amsikking/SOLS_O2-O3_optomechanics/animation/images/img0.png

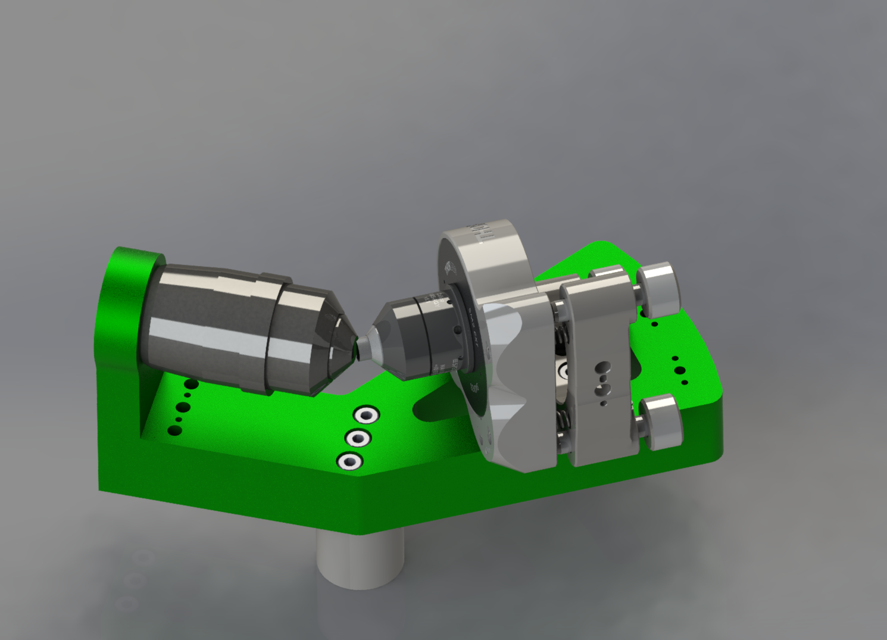
animation/images/img0.png
