amsikking/SOLS_O2-O3_optomechanics/animation/images/img1.png

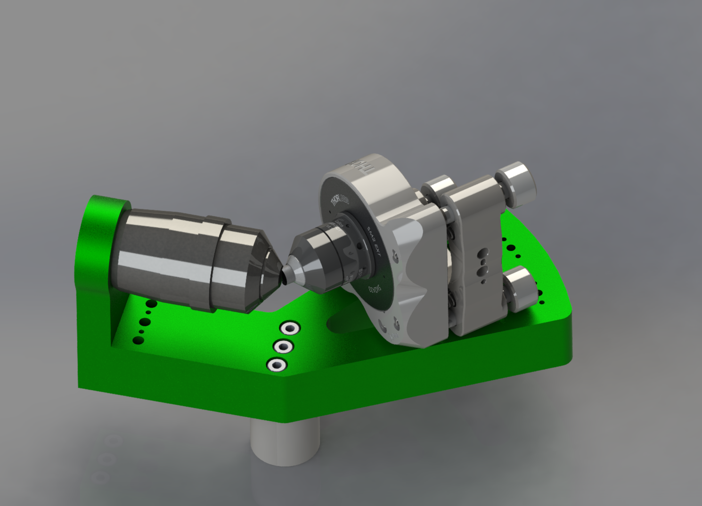
animation/images/img1.png
