amsikking/SOLS_O2-O3_optomechanics/animation/images/img2.png

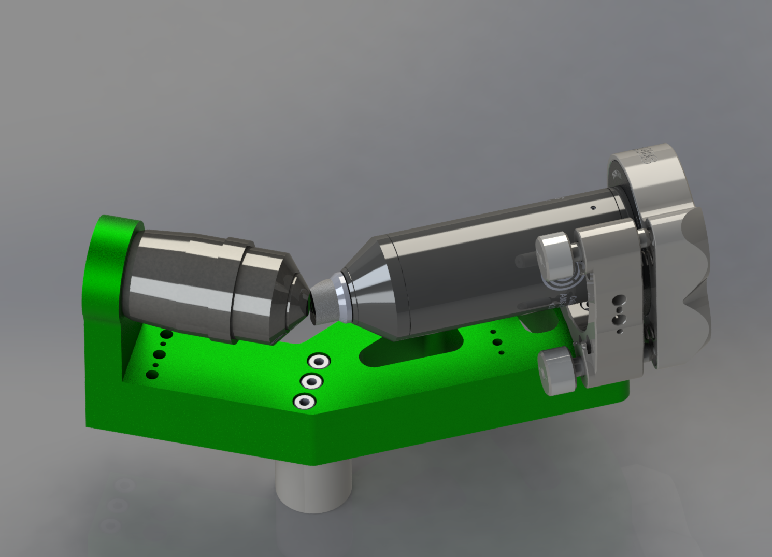
animation/images/img2.png
