amsikking/SOLS_O2-O3_optomechanics/animation/images/img3.png

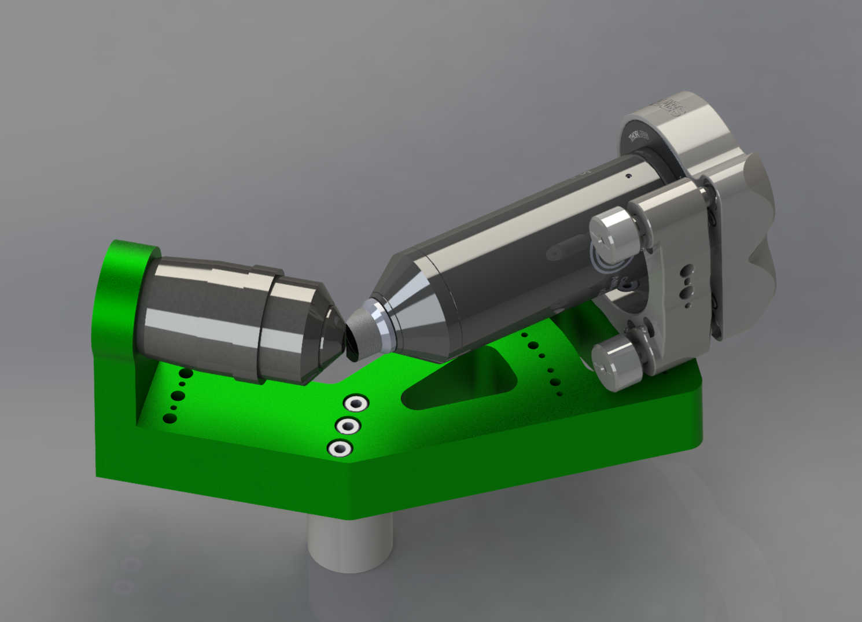
animation/images/img3.png
