amsikking/SOLS_O2-O3_optomechanics/animation/images/img7.png

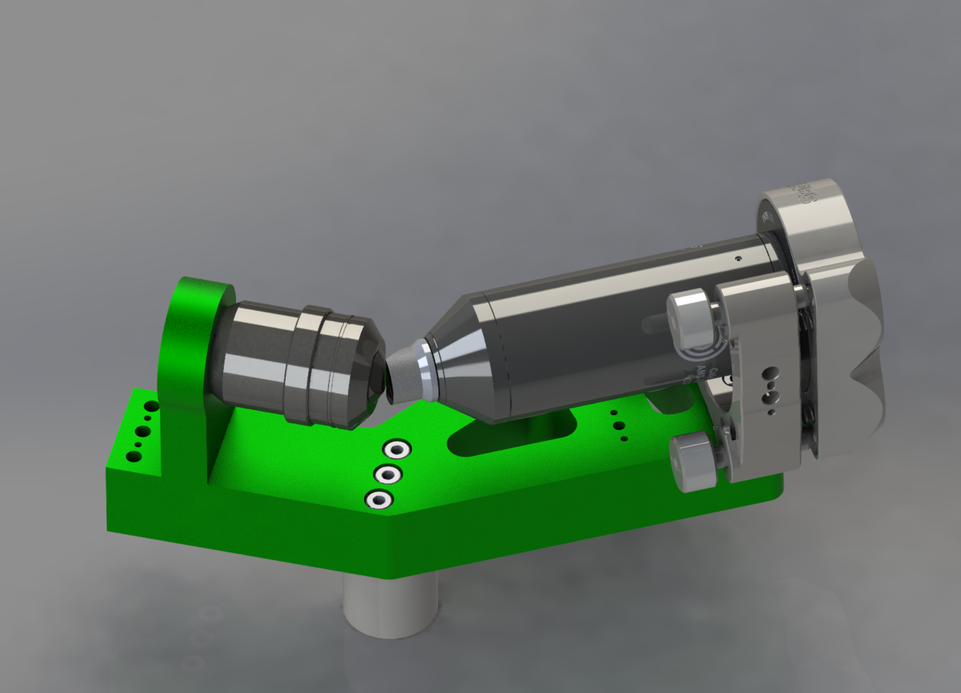
animation/images/img7.png
