amsikking/SOLS_O2-O3_optomechanics/animation/images/img9.png

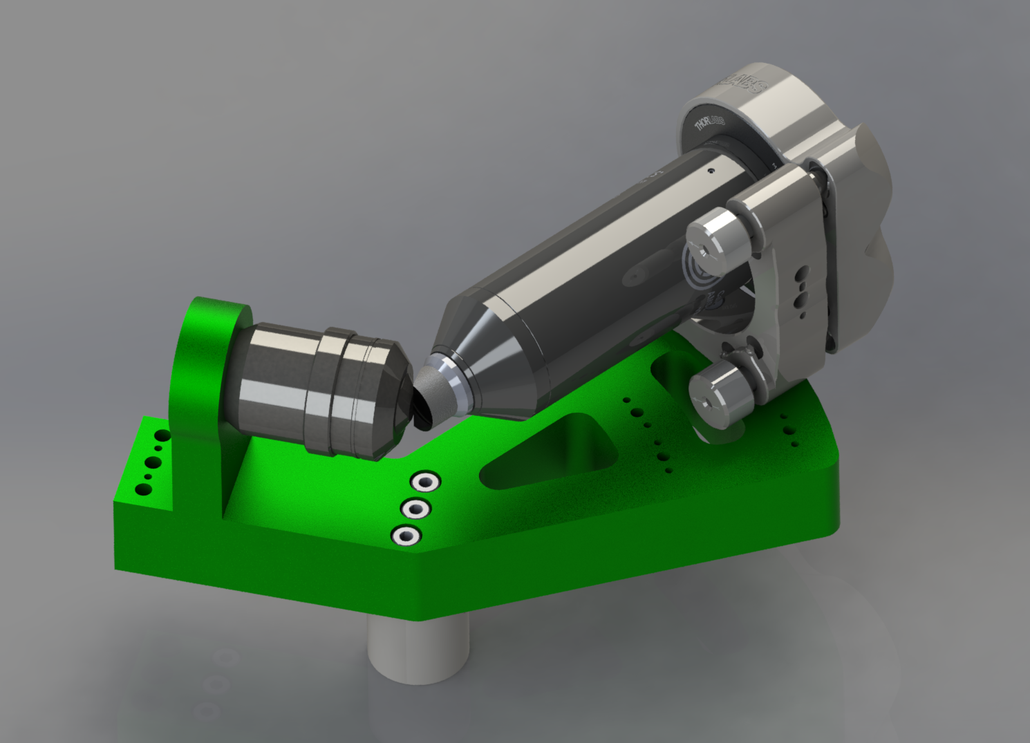
animation/images/img9.png
