amsikking/SOLS_O2-O3_optomechanics/nikon/MRD70470_40x0.95air_objective.png

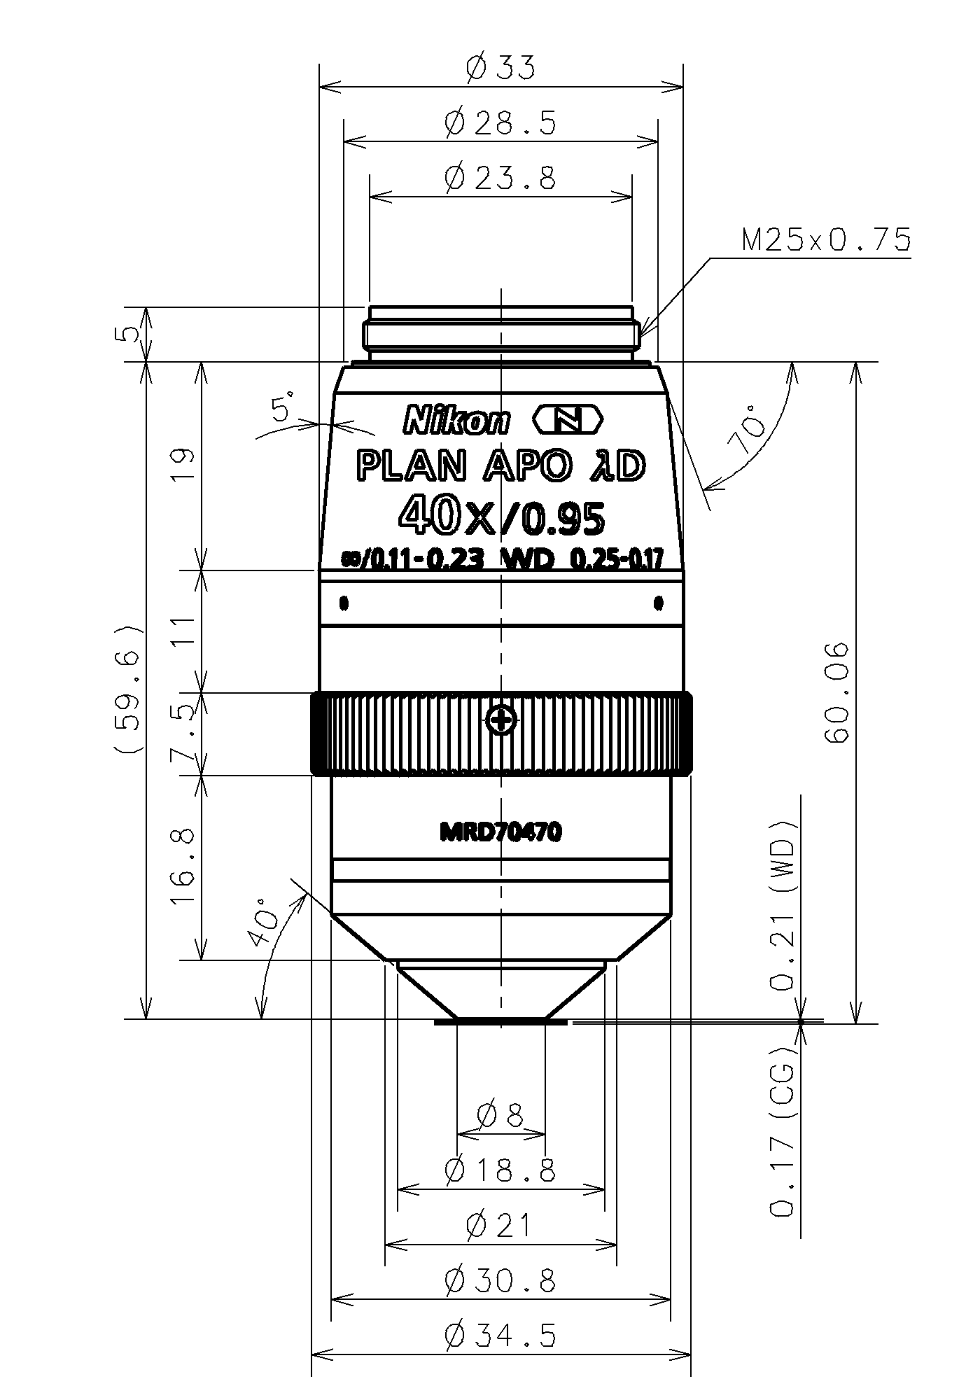
nikon/MRD70470_40x0.95air_objective.png
