amsikking/SOLS_O2-O3_optomechanics/olympus/UPLXAPO40x_40x0.95air_objective.jpg

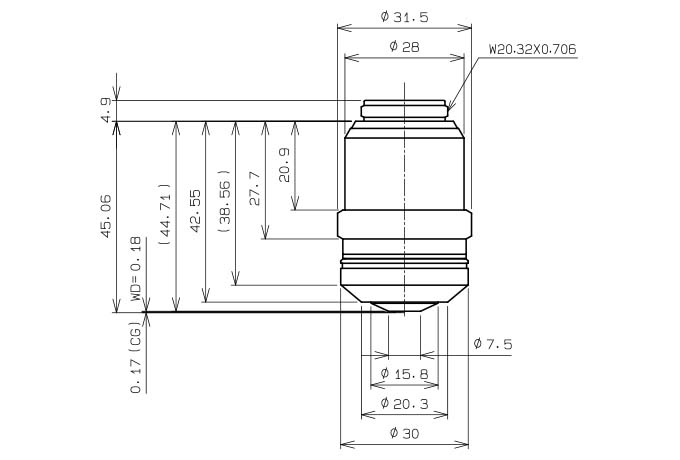
olympus/UPLXAPO40x_40x0.95air_objective.jpg
