amsikking/SOLS_O2-O3_optomechanics/stiffness_testing/02_optical_table.jpg

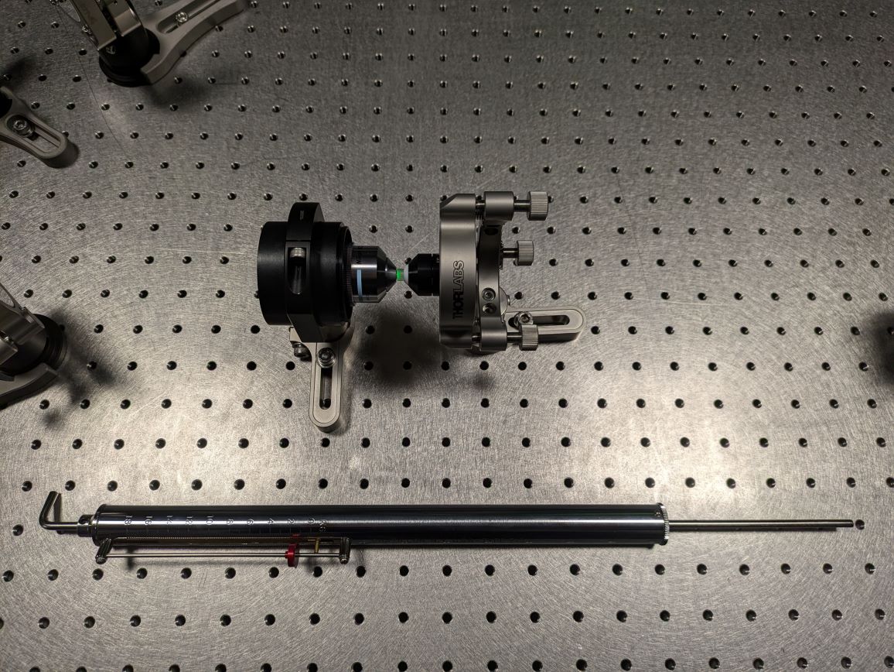
stiffness_testing/02_optical_table.jpg
