amsikking/SOLS_O2-O3_optomechanics/stiffness_testing/07_optical_table_cross_brace_direct_close-up.jpg

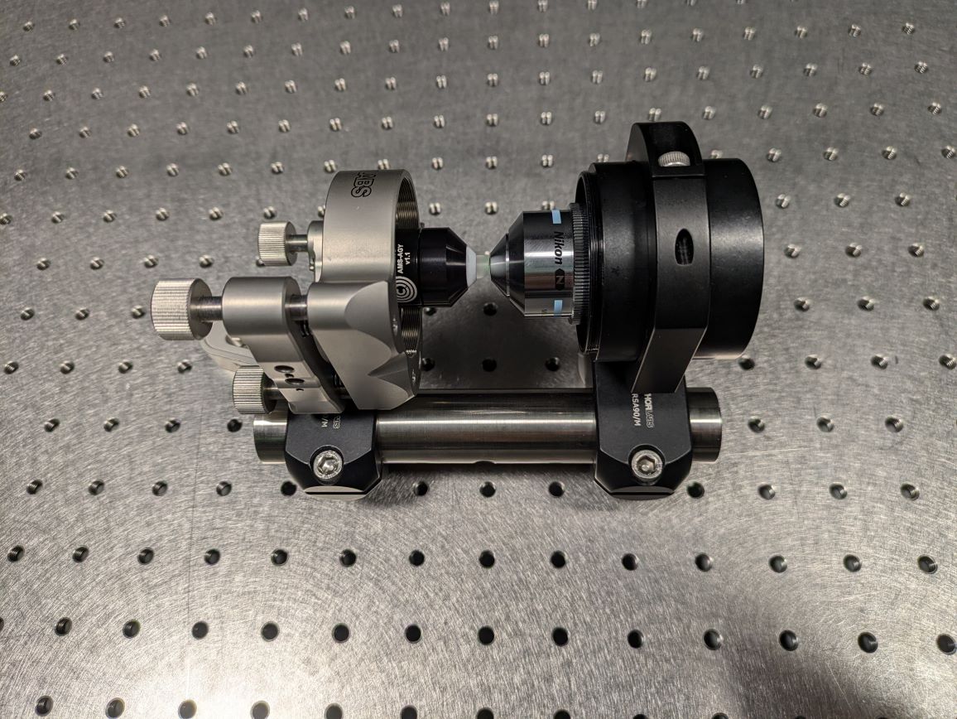
stiffness_testing/07_optical_table_cross_brace_direct_close-up.jpg
