amsikking/SOLS_O2-O3_optomechanics/AMS-AGY/AMS-AGY_v1_54-10-5_RevB.SLDPRT

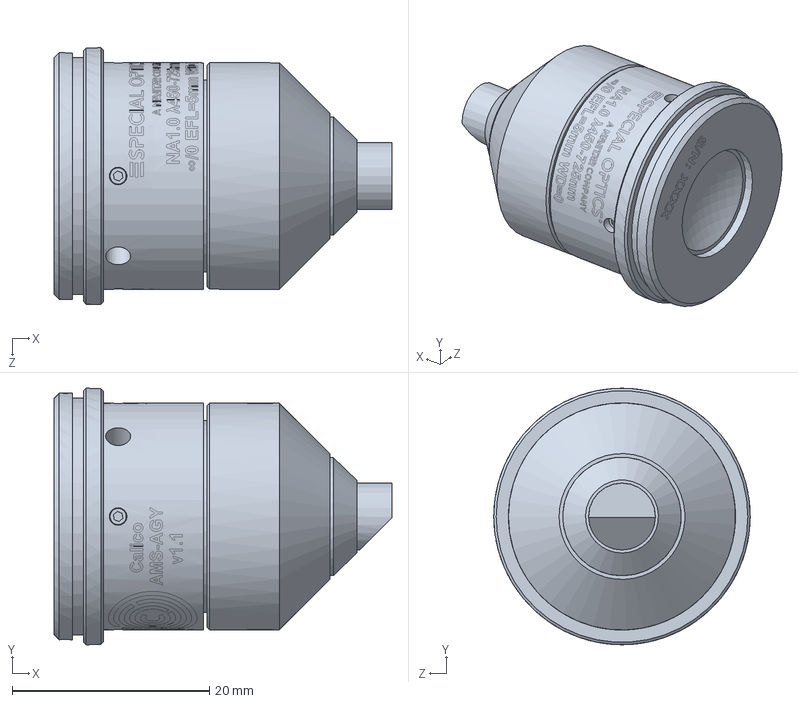
[picture p13: CAD file, 2025-02-11]
AMS-AGY/AMS-AGY_v1_54-10-5_RevB.SLDPRT
34.2 x 26.0 x 26.0 mm
