amsikking/SOLS_O2-O3_optomechanics/olympus/UPLXAPO40x_40x0.95air_objective.SLDPRT

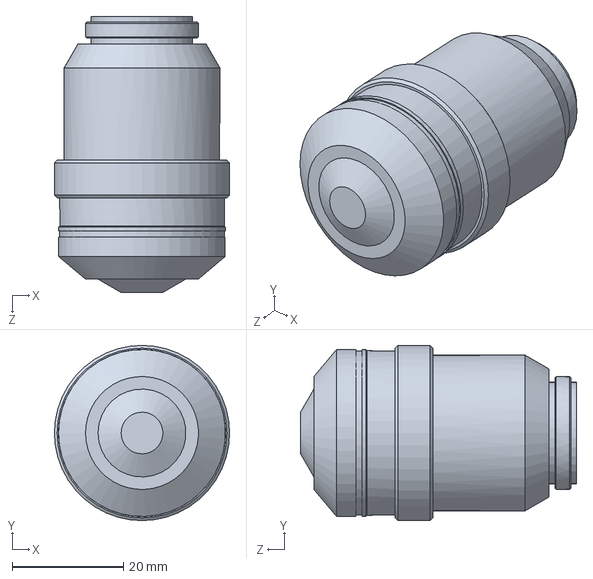
[picture p14: CAD file, 2025-02-11]
olympus/UPLXAPO40x_40x0.95air_objective.SLDPRT
31.5 x 31.5 x 49.6 mm
