amsikking/SOLS_O2-O3_optomechanics/AMS-AGY/AMS-AGY_v2_54-18-9_RevA.SLDPRT

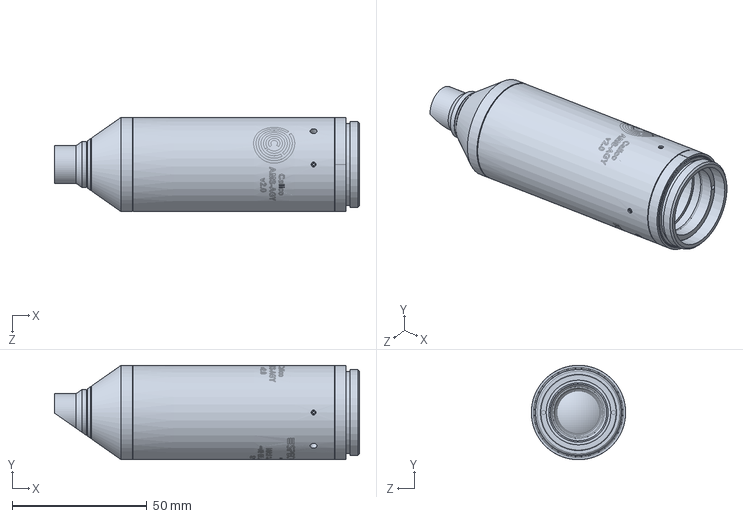
[picture p16: CAD file, 2025-02-11]
AMS-AGY/AMS-AGY_v2_54-18-9_RevA.SLDPRT
113.2 x 35.0 x 35.0 mm
