amsikking/SOLS_O2-O3_optomechanics/mcmastercarr/91292A130_socket_head_screw_M4x30mm.SLDPRT

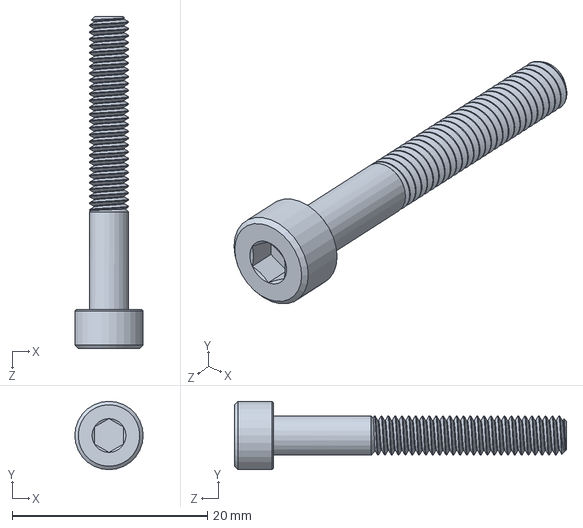
[picture p18: CAD file, 2025-02-11]
mcmastercarr/91292A130_socket_head_screw_M4x30mm.SLDPRT
7.00 x 7.00 x 34.0 mm
