amsikking/SOLS_O2-O3_optomechanics/nikon/MRD70470_40x0.95air_objective.SLDPRT

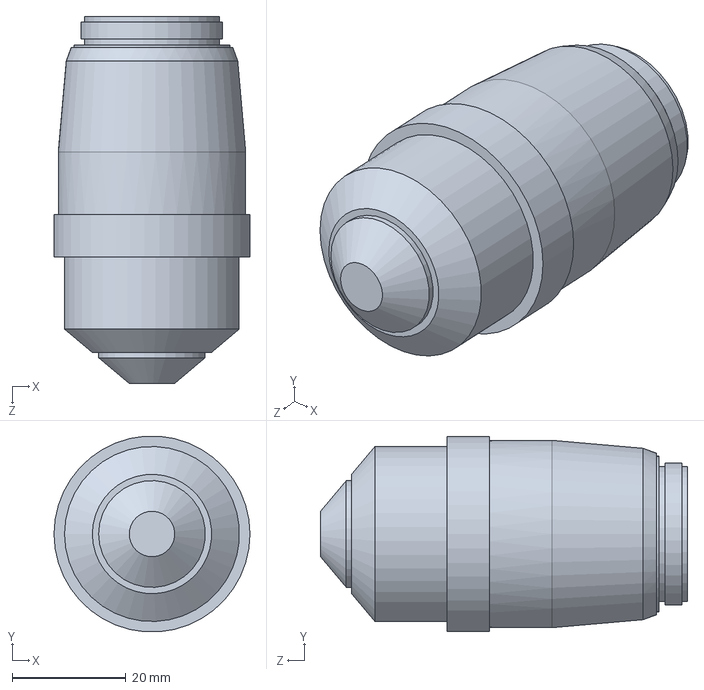
[picture p19: CAD file, 2025-02-11]
nikon/MRD70470_40x0.95air_objective.SLDPRT
34.5 x 34.4 x 64.6 mm
