amsikking/SOLS_O2-O3_optomechanics/thorlabs/POLARIS-K2T_lens_ring.sldprt

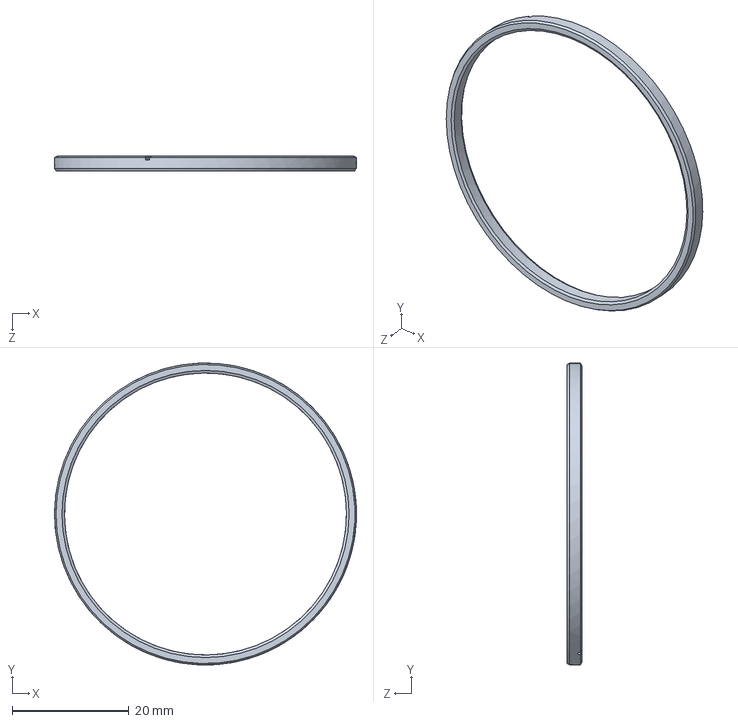
[picture p20: CAD file, 2025-02-11]
thorlabs/POLARIS-K2T_lens_ring.sldprt
51.7 x 51.7 x 2.54 mm
