amsikking/SOLS_O2-O3_optomechanics/mcmastercarr/91292A117_socket_head_screw_M4x12mm.SLDPRT

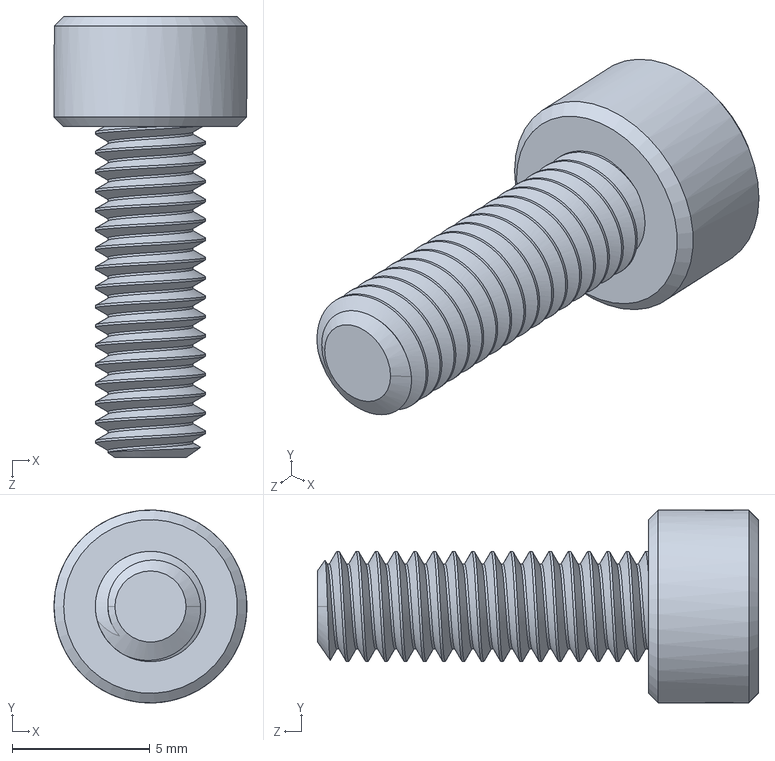
[picture p21: CAD file, 2025-02-11]
mcmastercarr/91292A117_socket_head_screw_M4x12mm.SLDPRT
7.00 x 6.99 x 16.0 mm
