amsikking/SOLS_O2-O3_optomechanics/thorlabs/PLS-T242_M.sldprt

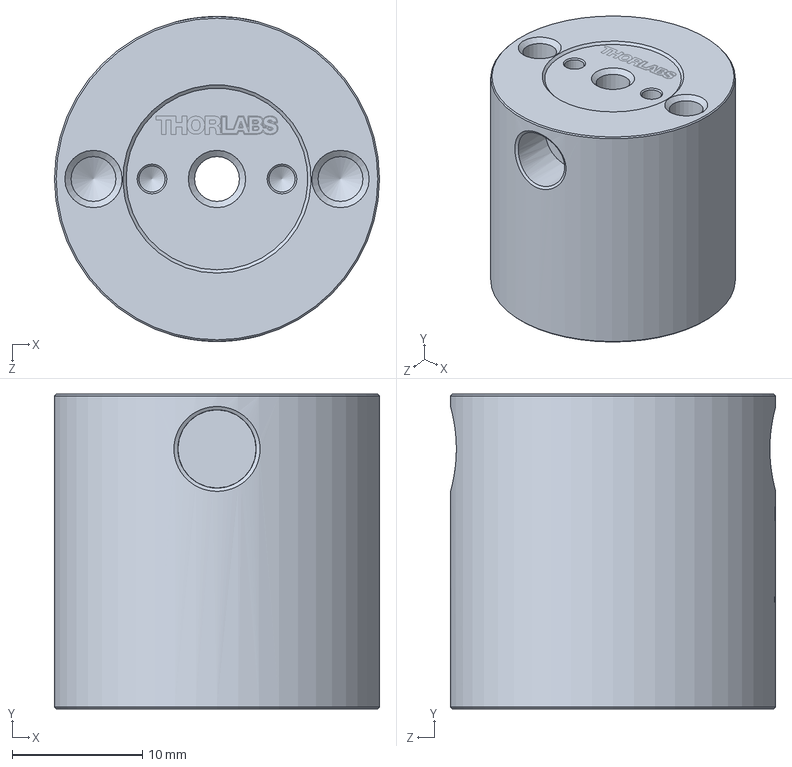
[picture p22: CAD file, 2025-02-11]
thorlabs/PLS-T242_M.sldprt
25.0 x 24.2 x 25.0 mm
