amsikking/SOLS_O2-O3_optomechanics/mcmastercarr/91585A214_dowel_pin_2x8mm.SLDPRT

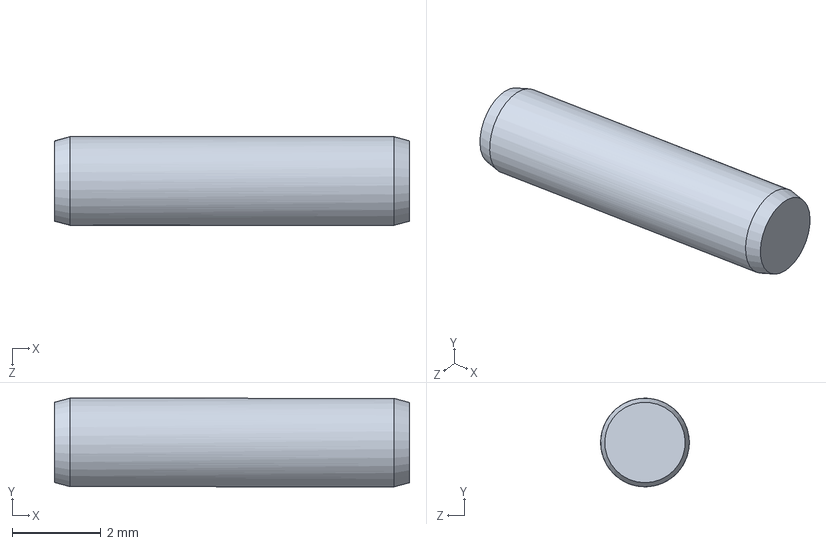
[picture p23: CAD file, 2025-02-11]
mcmastercarr/91585A214_dowel_pin_2x8mm.SLDPRT
8.00 x 2.00 x 2.00 mm
