amsikking/SOLS_O2-O3_optomechanics/thorlabs/SM2A22.sldprt

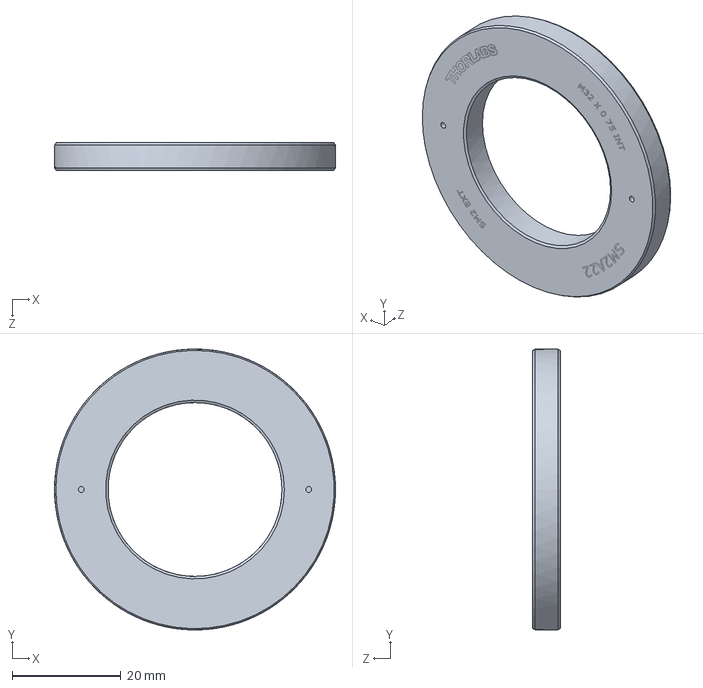
[picture p24: CAD file, 2025-02-11]
thorlabs/SM2A22.sldprt
51.7 x 51.7 x 5.08 mm
