amsikking/SOLS_O2-O3_optomechanics/thorlabs/SM2A33.sldprt

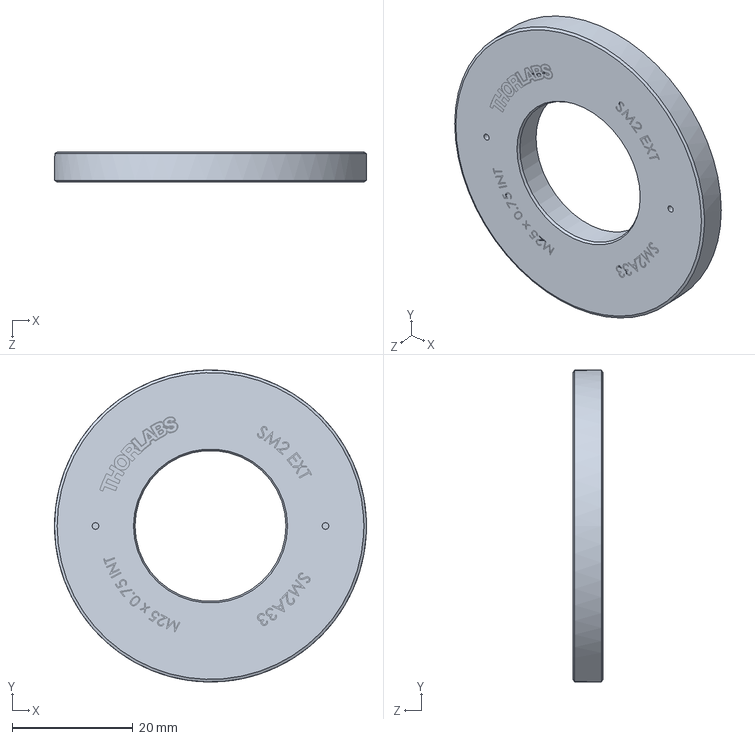
[picture p25: CAD file, 2025-02-11]
thorlabs/SM2A33.sldprt
51.7 x 51.7 x 4.98 mm
