amsikking/SOLS_O2-O3_optomechanics/thorlabs/POLARIS-K2T_base_plate.sldprt

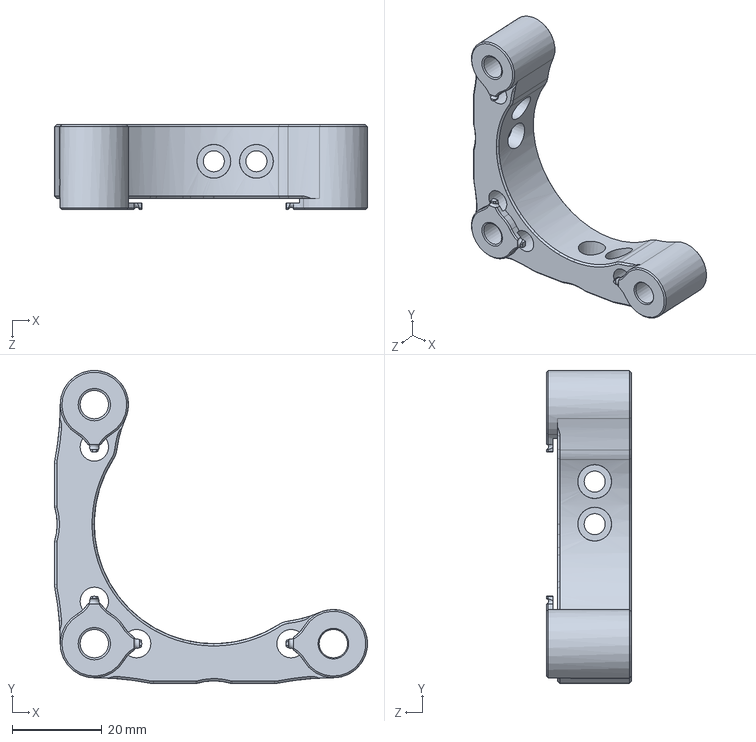
[picture p26: CAD file, 2025-02-11]
thorlabs/POLARIS-K2T_base_plate.sldprt
69.8 x 69.8 x 19.0 mm
