amsikking/SOLS_O2-O3_optomechanics/(list of files, cad)

Other CAD files:
parts/SOLS_O2-O3_baseplate_left_v1.0.STEP
SOLS_O2-O3_left_v1.0.SLDDRW
parts/SOLS_O2-O3_baseplate_left_v1.0.SLDDRW
parts/SOLS_O2-O3_baseplate_left_v1.0.SLDPRT
parts/SOLS_O2-O3_baseplate_right_v1.0.SLDDRW
parts/SOLS_O2-O3_baseplate_right_v1.0.SLDPRT
parts/SOLS_O2-O3_objective_mount_v1.0.SLDDRW
parts/SOLS_O2-O3_objective_mount_v1.0.SLDPRT
