amsikking/SOLS_O2-O3_optomechanics/stiffness_testing/00_collimation_check.jpg

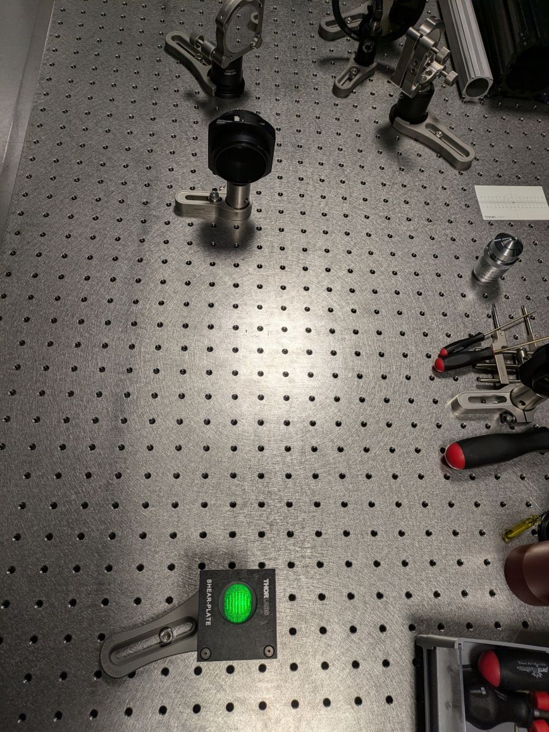
stiffness_testing/00_collimation_check.jpg
