amsikking/SOLS_O2-O3_optomechanics/stiffness_testing/01_force_test_example.jpg

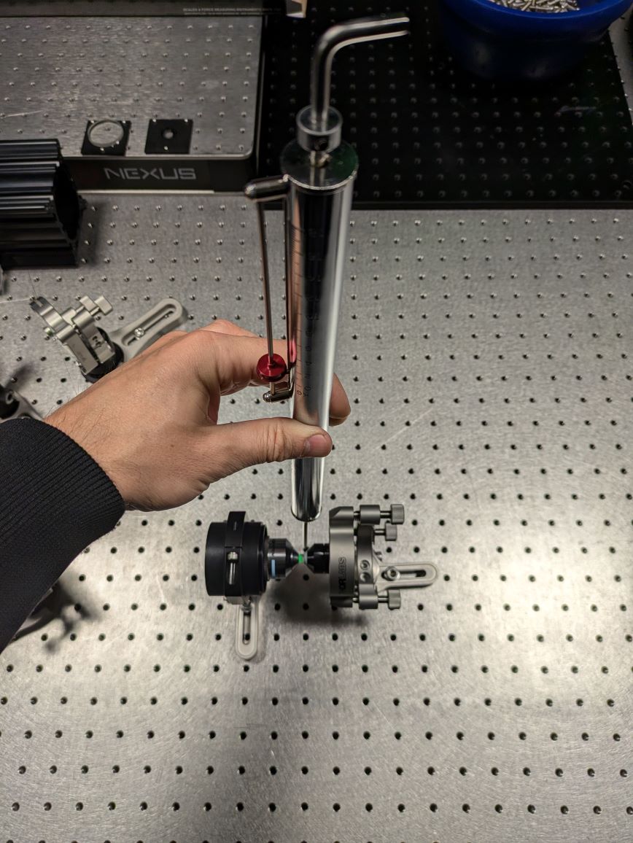
stiffness_testing/01_force_test_example.jpg
