amsikking/SOLS_O2-O3_optomechanics/stiffness_testing/03_breadboard.jpg

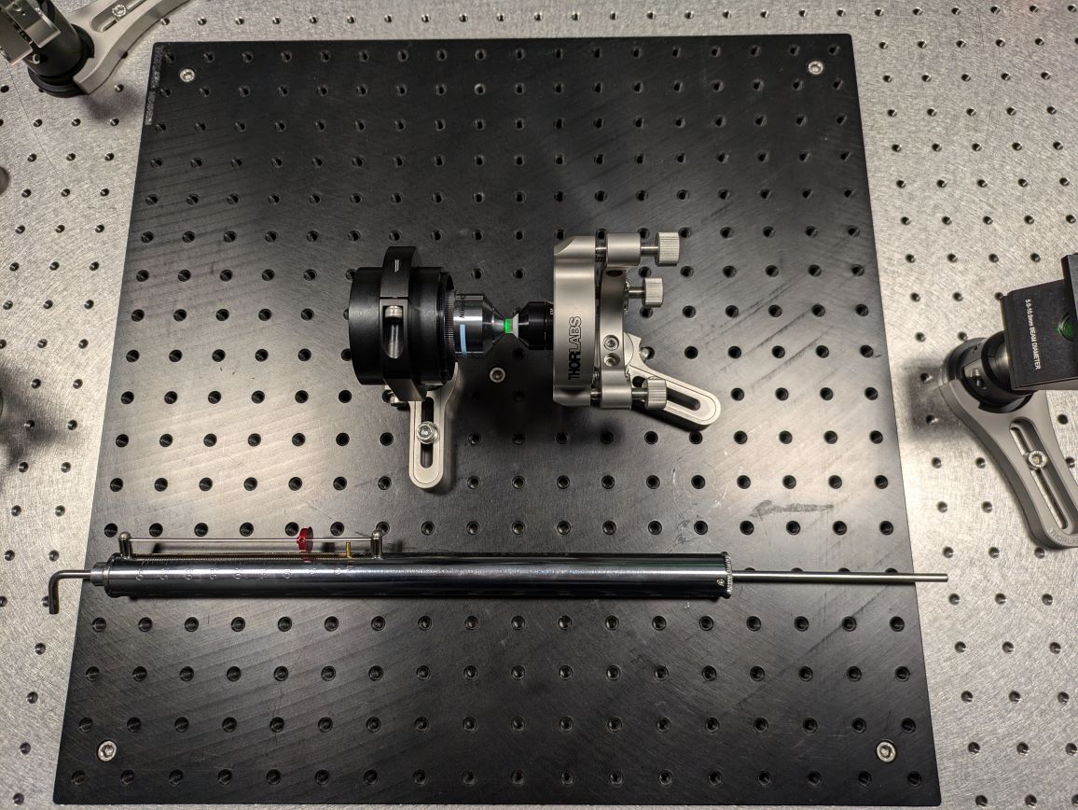
stiffness_testing/03_breadboard.jpg
