amsikking/SOLS_O2-O3_optomechanics/stiffness_testing/04_breadboard_cross_brace_adjacent.jpg

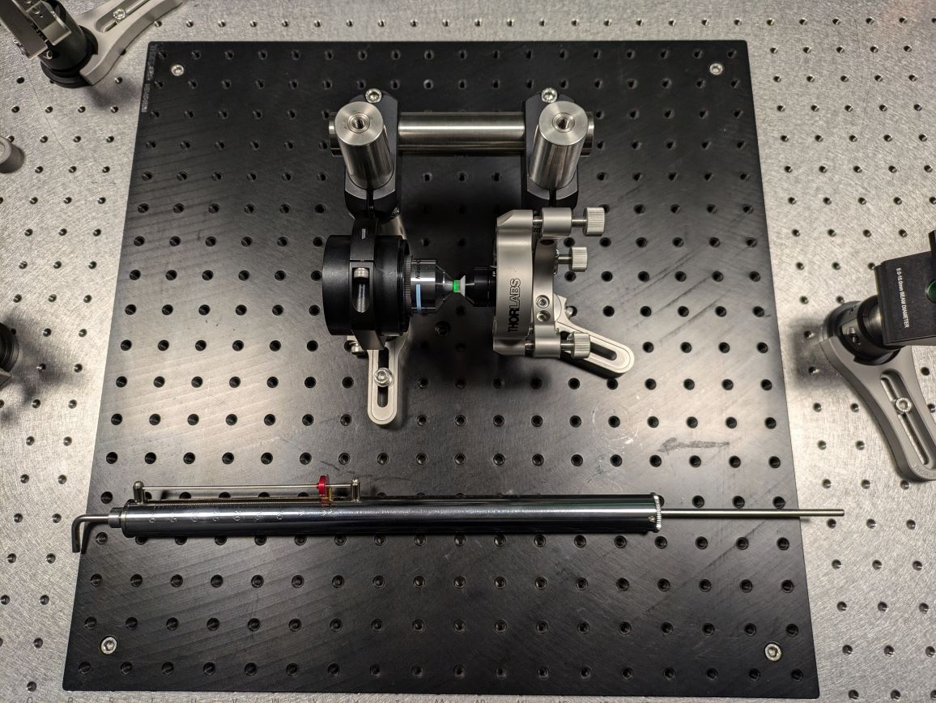
stiffness_testing/04_breadboard_cross_brace_adjacent.jpg
