amsikking/SOLS_O2-O3_optomechanics/stiffness_testing/05_breadboard_cross_brace_adjacent_double.jpg

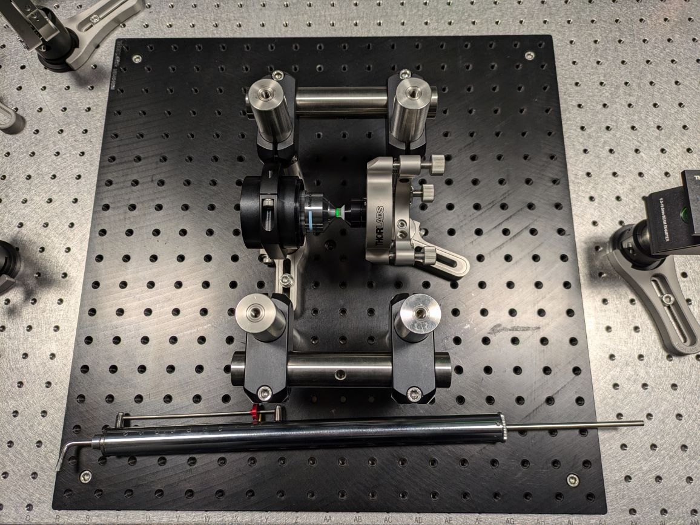
stiffness_testing/05_breadboard_cross_brace_adjacent_double.jpg
