amsikking/SOLS_O2-O3_optomechanics/stiffness_testing/06_breadboard_cross_brace_direct.jpg

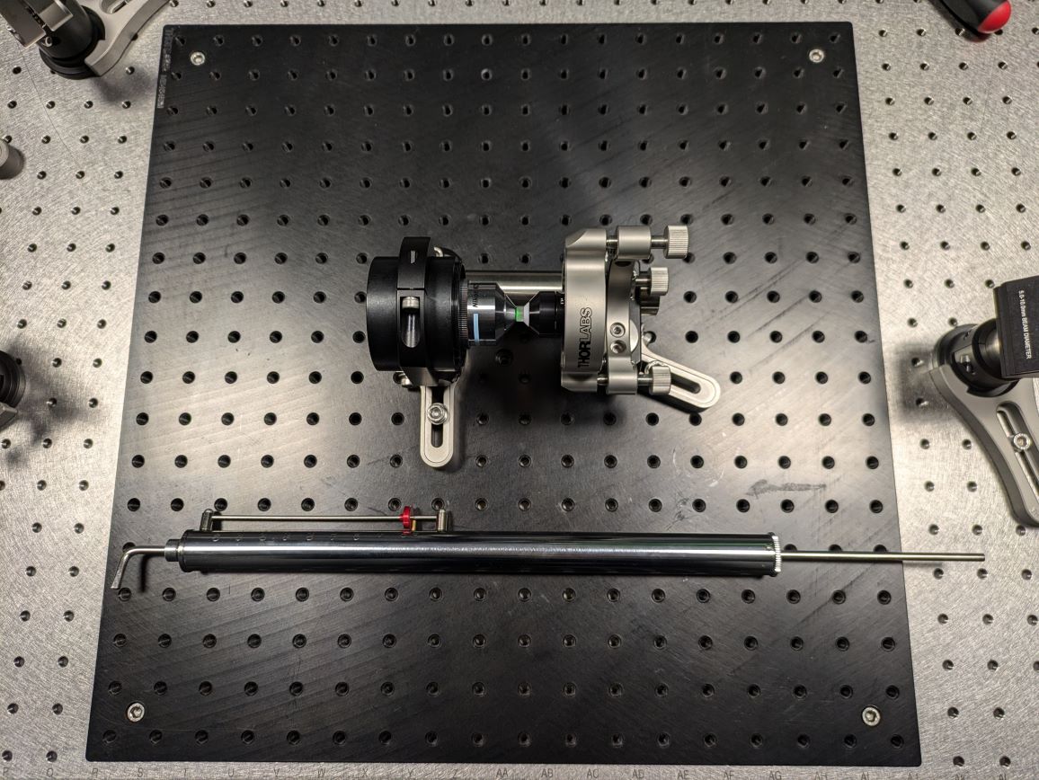
stiffness_testing/06_breadboard_cross_brace_direct.jpg
