amsikking/SOLS_O2-O3_optomechanics/stiffness_testing/08_breadboard_on_4_posts.jpg

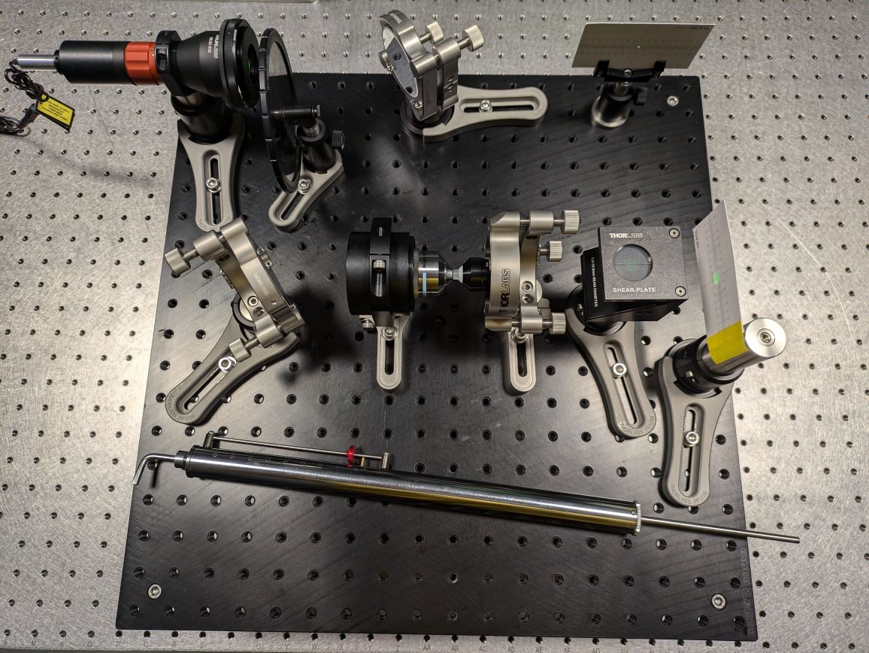
stiffness_testing/08_breadboard_on_4_posts.jpg
