amsikking/SOLS_O2-O3_optomechanics/stiffness_testing/09_breadboard_on_4_posts_cross_brace_directly_under.jpg

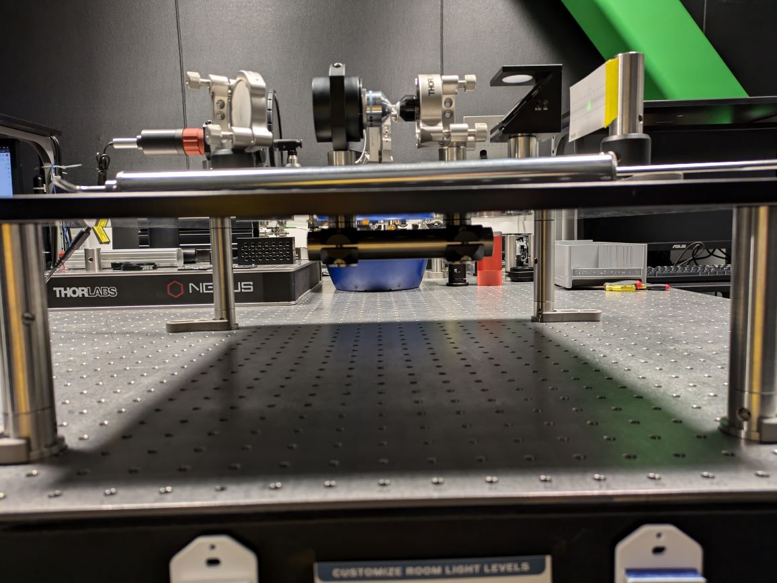
stiffness_testing/09_breadboard_on_4_posts_cross_brace_directly_under.jpg
