amsikking/SOLS_O2-O3_optomechanics/stiffness_testing/10_breadboard_with_tombstone.jpg

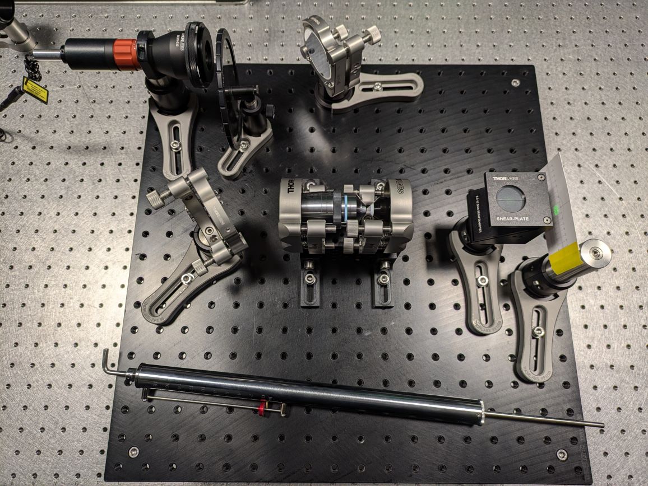
stiffness_testing/10_breadboard_with_tombstone.jpg
