amsikking/SOLS_O2-O3_optomechanics/SOLS_O2-O3_left_v1.0.PDF

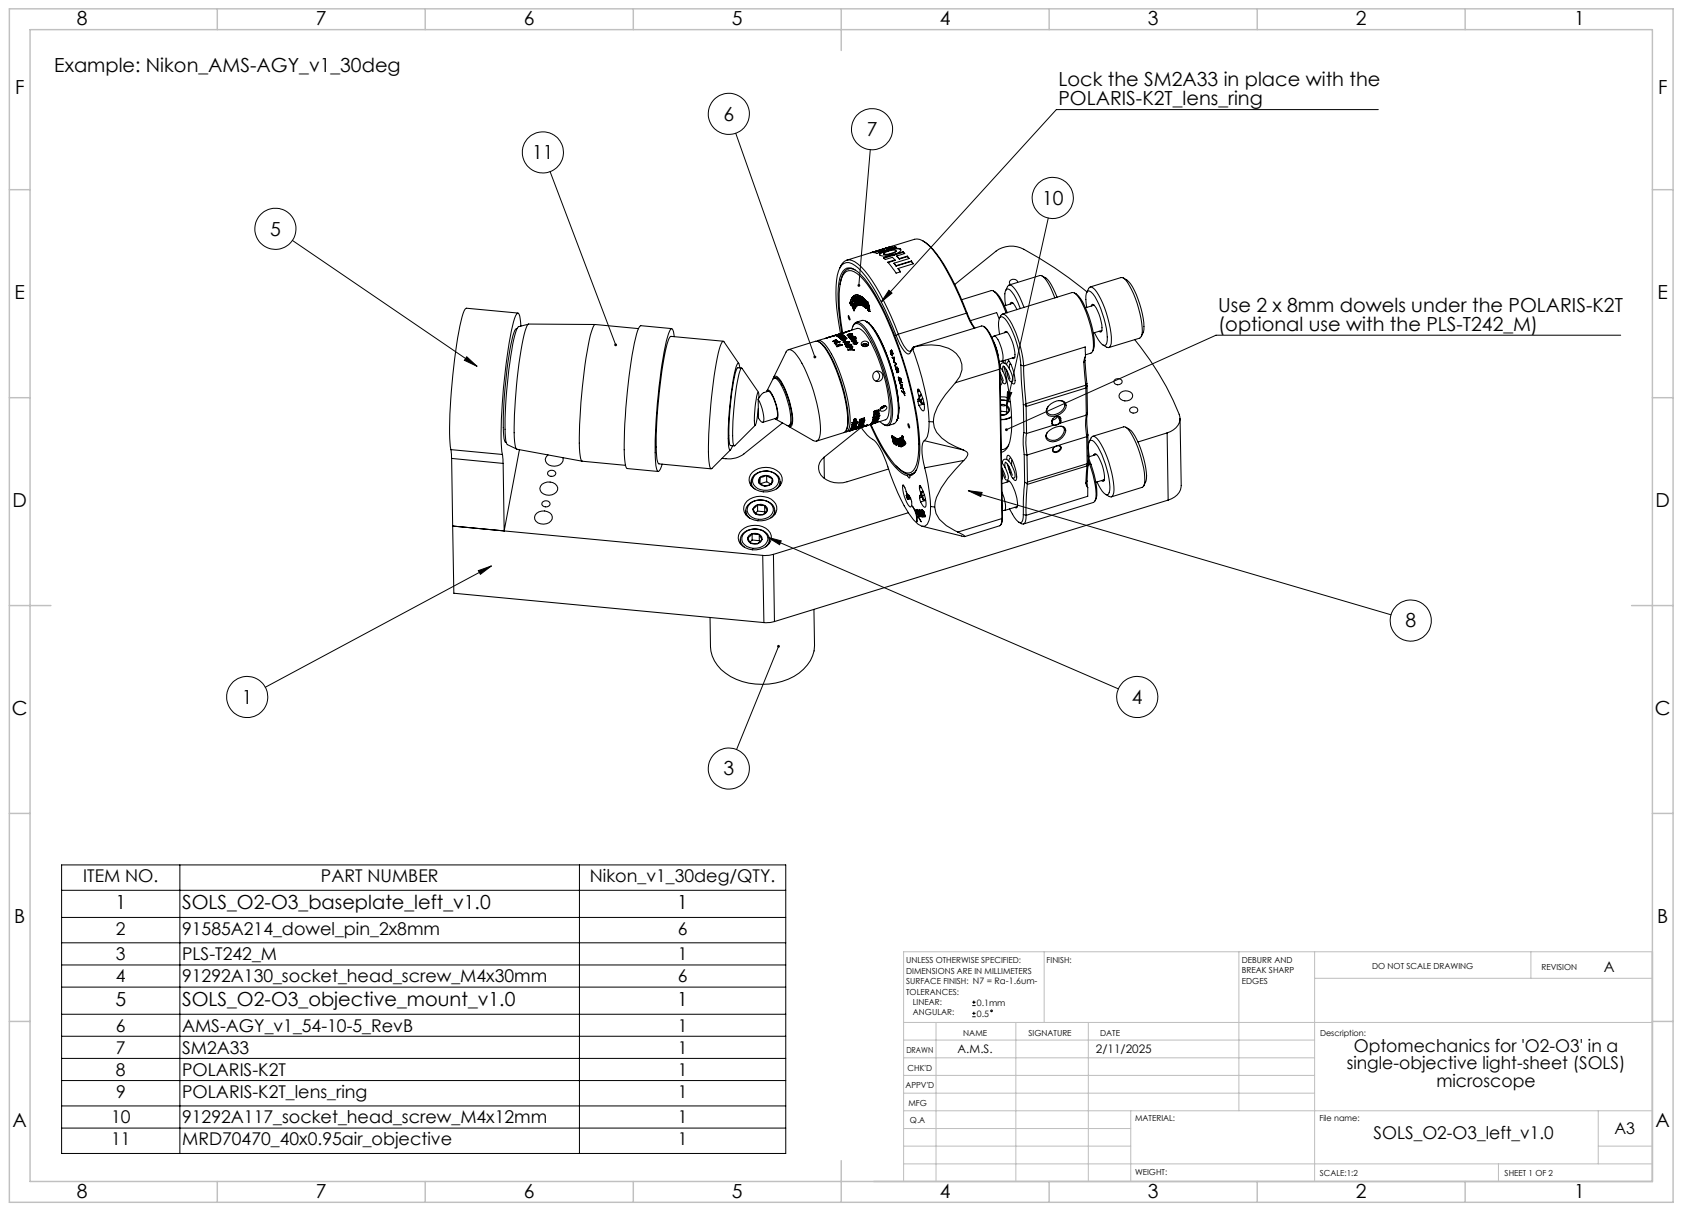
[picture p39: page 1]
Example: Nikon_AMS-AGY_v1_30deg; FINISH:; DEBURR AND; BREAK SHARP; DO NOT SCALE DRAWING; REVISION; SCALE:1:2; SHEET 1 OF 2

Lock the SM2A33 in place with the
POLARIS-K2T_lens_ring

Use 2 x 8mm dowels under the POLARIS-K2T
(optional use with the PLS-T242_M)

ITEM NO. | PART NUMBER | Nikon_v1_30deg/QTY.
1 | SOLS_O2-O3_baseplate_left_v1.0 | 1
2 | 91585A214_dowel_pin_2x8mm | 6
3 | PLS-T242_M | 1
4 | 91292A130_socket_head_screw_M4x30mm | 6
5 | SOLS_O2-O3_objective_mount_v1.0 | 1
6 | AMS-AGY_v1_54-10-5_RevB | 1

UNLESS OTHERWISE SPECIFIED:
DIMENSIONS ARE IN MILLIMETERS
SURFACE FINISH:
TOLERANCES:
LINEAR:
ANGULAR:

NAME | SIGNATURE | DATE | Description: Optomechanics for 'O2-O3' in a single-objective light-sheet (SOLS) microscope

9 | POLARIS-K2T_lens_ring | 1
10 | 91292A117_socket_head_screw_M4x12mm | 1
11 | MRD70470_40x0.95air_objective | 1

APPV'D
MFG
Q.A | MATERIAL: | File name: SOLS_O2-O3_left_v1.0 | A3

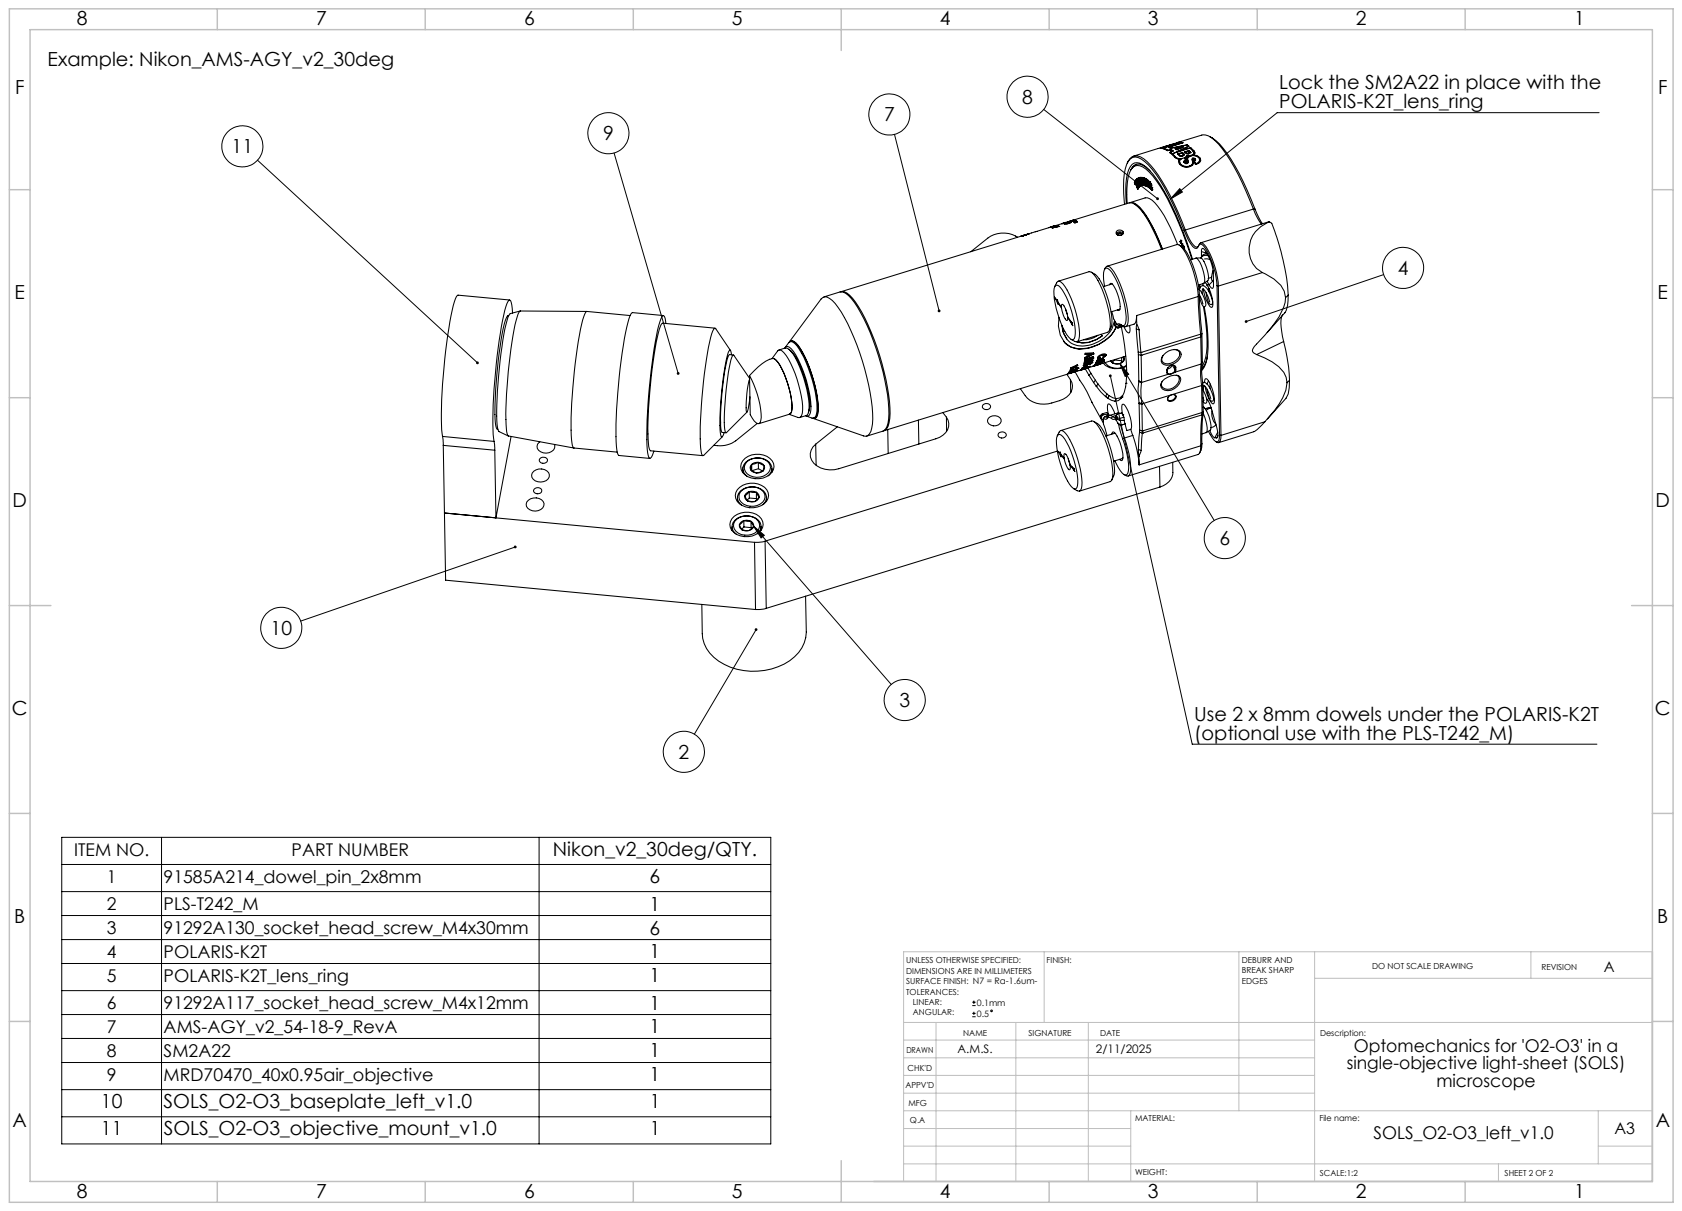
[picture p40: page 2]
Example: Nikon_AMS-AGY_v2_30deg; FINISH:; DEBURR AND; BREAK SHARP; DO NOT SCALE DRAWING; REVISION; File name:; SCALE:1:2; SHEET 2 OF 2

Lock the SM2A22 in place with the
POLARIS-K2T_lens_ring

Use 2 x 8mm dowels under the POLARIS-K2T
(optional use with the PLS-T242_M)

ITEM NO. | PART NUMBER | Nikon_v2_30deg/QTY.
1 | 91585A214_dowel_pin_2x8mm | 6
2 | PLS-T242_M | 1
3 | 91292A130_socket_head_screw_M4x30mm | 6
4 | POLARIS-K2T | 1
5 | POLARIS-K2T_lens_ring | 1
6 | 91292A117_socket_head_screw_M4x12mm | 1
7 | AMS-AGY_v2_54-18-9_RevA | 1

UNLESS OTHERWISE SPECIFIED:
DIMENSIONS ARE IN MILLIMETERS
SURFACE FINISH:
TOLERANCES:
LINEAR:
ANGULAR:

NAME | SIGNATURE | DATE | Description: Optomechanics for 'O2-O3' in a single-objective light-sheet (SOLS) microscope

9 | MRD70470_40x0.95air_objective | 1

CHK'D
APPV'D
