amsikking/SOLS_O2-O3_optomechanics/thorlabs/PLS-T242_M-AutoCADPDF.pdf

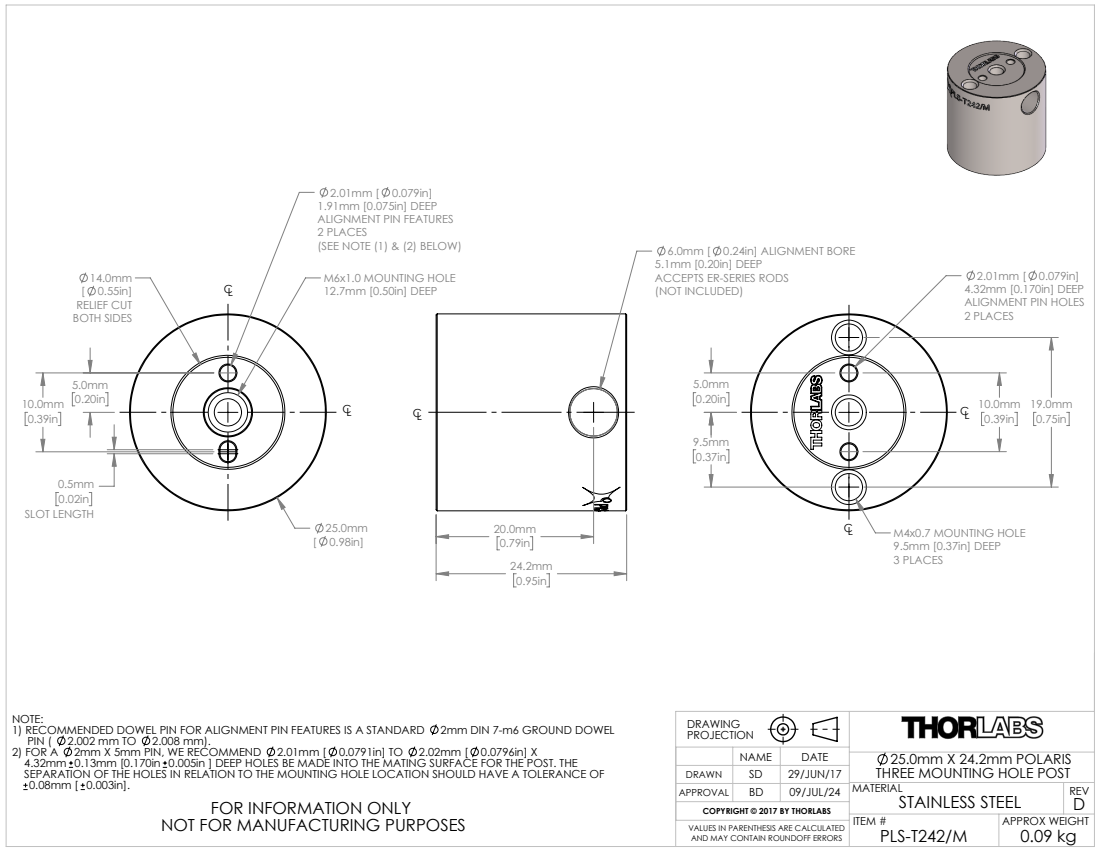
[picture p41: page 1]
M4x0.7 MOUNTING HOLE 9.5mm [0.37in] DEEP 3 PLACES; 2.01mm [ 0.079in] 4.32mm [0.170in] DEEP ALIGNMENT PIN HOLES 2 PLACES; [ 0.55in] RELIEF CUT BOTH SIDES; M6x1.0 MOUNTING HOLE 12.7mm [0.50in] DEEP; SLOT LENGTH; ITEM #; APPROX WEIGHT; NAME; 25.0mm X 24.2mm POLARIS; FOR INFORMATION ONLY; COPYRIGHT © 2017 BY THORLABS

1.91mm [0.075in] DEEP
ALIGNMENT PIN FEATURES
2 PLACES
(SEE NOTE (1) & (2) BELOW)

6.0mm [ 0.24in] ALIGNMENT BORE
5.1mm [0.20in] DEEP
ACCEPTS ER-SERIES RODS
(NOT INCLUDED)

NOTE:
1) RECOMMENDED DOWEL PIN FOR ALIGNMENT PIN FEATURES IS A STANDARD 2mm DIN 7-m6 GROUND DOWEL
PIN ( 2.002 mm TO 2.008 mm).
2) FOR A 2mm X 5mm PIN, WE RECOMMEND 2.01mm [ 0.0791in] TO 2.02mm [ 0.0796in] X
4.32mm 0.13mm [0.170in 0.005in ] DEEP HOLES BE MADE INTO THE MATING SURFACE FOR THE POST. THE
SEPARATION OF THE HOLES IN RELATION TO THE MOUNTING HOLE LOCATION SHOULD HAVE A TOLERANCE OF

DRAWN | SD | 29/JUN/17
APPROVAL | BD | 09/JUL/24 | MATERIAL STAINLESS STEEL | REV D

THREE MOUNTING HOLE POST

NOT FOR MANUFACTURING PURPOSES

0.09 kg VALUES IN PARENTHESIS ARE CALCULATED
AND MAY CONTAIN ROUNDOFF ERRORS
