amsikking/SOLS_O2-O3_optomechanics/thorlabs/POLARIS-K2T-AutoCADPDF.pdf

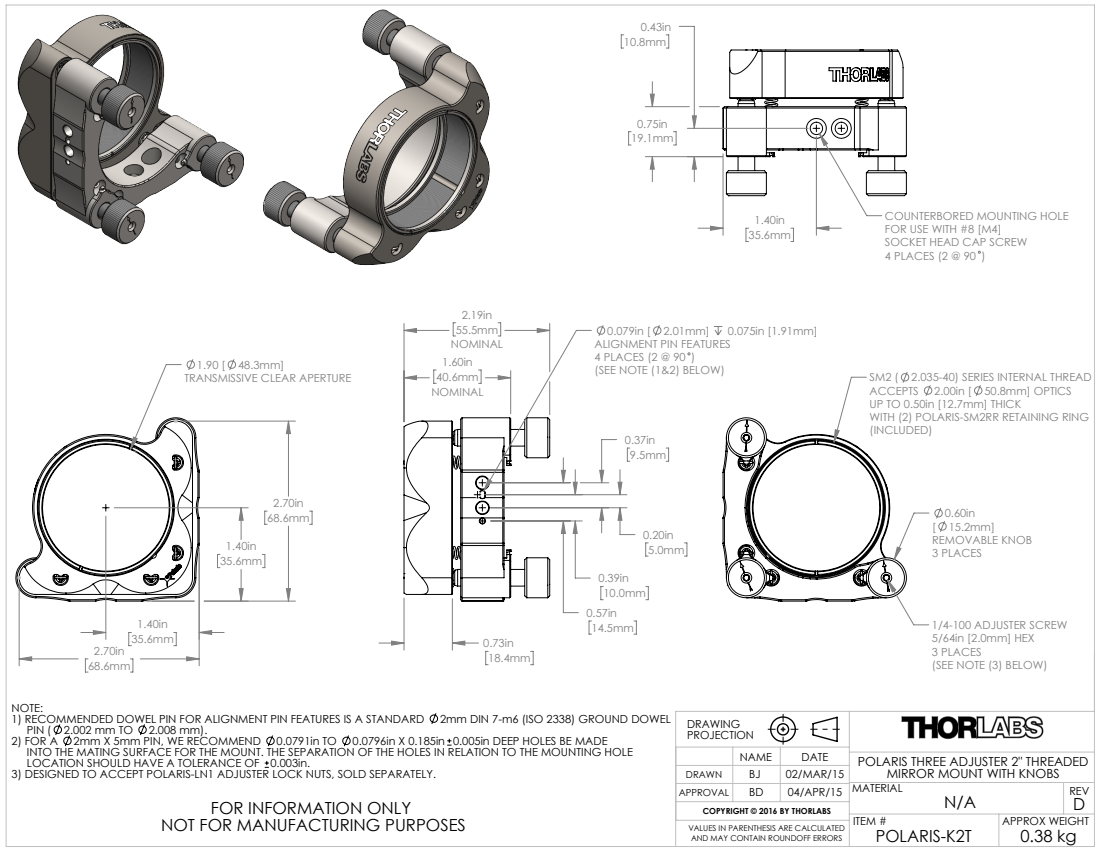
[picture p42: page 1]
[ 15.2mm] REMOVABLE KNOB 3 PLACES; ITEM #; APPROX WEIGHT; NAME; POLARIS THREE ADJUSTER 2" THREADED; FOR INFORMATION ONLY; COPYRIGHT © 2016 BY THORLABS

COUNTERBORED MOUNTING HOLE
FOR USE WITH #8 [M4]
SOCKET HEAD CAP SCREW
4 PLACES (2 @ 90 )

ALIGNMENT PIN FEATURES
(SEE NOTE (1&2) BELOW)

TRANSMISSIVE CLEAR APERTURE

SM2 ( 2.035-40) SERIES INTERNAL THREAD
ACCEPTS 2.00in [ 50.8mm] OPTICS
UP TO 0.50in [12.7mm] THICK
WITH (2) POLARIS-SM2RR RETAINING RING
(INCLUDED)

1/4-100 ADJUSTER SCREW
5/64in [2.0mm] HEX
3 PLACES
(SEE NOTE (3) BELOW)

NOTE:
1) RECOMMENDED DOWEL PIN FOR ALIGNMENT PIN FEATURES IS A STANDARD 2mm DIN 7-m6 (ISO 2338) GROUND DOWEL
PIN ( 2.002 mm TO 2.008 mm).
2) FOR A 2mm X 5mm PIN, WE RECOMMEND 0.0791in TO 0.0796in X 0.185in 0.005in DEEP HOLES BE MADE
INTO THE MATING SURFACE FOR THE MOUNT. THE SEPARATION OF THE HOLES IN RELATION TO THE MOUNTING HOLE
LOCATION SHOULD HAVE A TOLERANCE OF 0.003in.
3) DESIGNED TO ACCEPT POLARIS-LN1 ADJUSTER LOCK NUTS, SOLD SEPARATELY.

DRAWN | BJ | 02/MAR/15
APPROVAL | BD | 04/APR/15 | MATERIAL N/A | REV D

MIRROR MOUNT WITH KNOBS

NOT FOR MANUFACTURING PURPOSES

0.38 kg VALUES IN PARENTHESIS ARE CALCULATED
AND MAY CONTAIN ROUNDOFF ERRORS
