amsikking/SOLS_O2-O3_optomechanics/thorlabs/SM2A22-AutoCADPDF.pdf

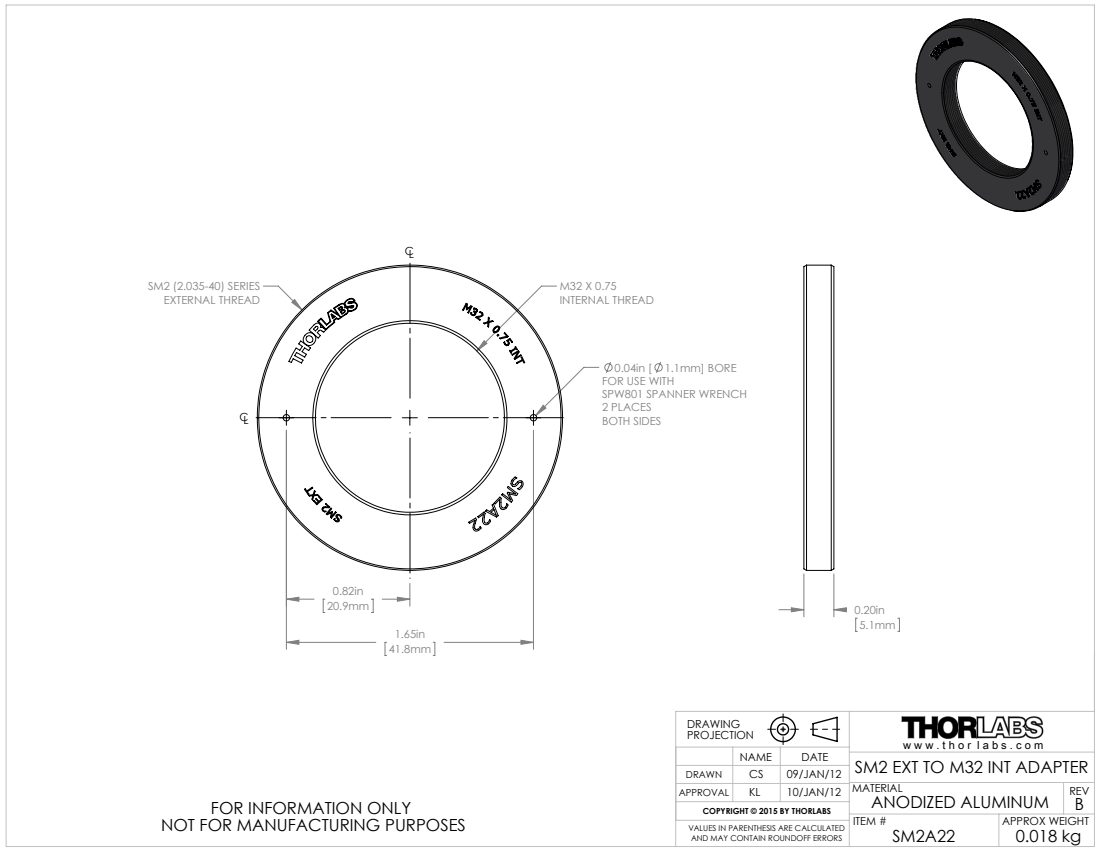
[picture p43: page 1]
M32 X 0.75 INTERNAL THREAD; SM2 (2.035-40) SERIES EXTERNAL THREAD; ITEM #; APPROX WEIGHT; FOR INFORMATION ONLY; COPYRIGHT © 2015 BY THORLABS

0.04in [ 1.1mm] BORE
FOR USE WITH
SPW801 SPANNER WRENCH
2 PLACES
BOTH SIDES

DRAWING PROJECTION | | w w w . t h o r l a b s . c o m

NAME | DATE
APPROVAL | KL | 10/JAN/12 | MATERIAL ANODIZED ALUMINUM | REV B

SM2 EXT TO M32 INT ADAPTER

DRAWN | CS | 09/JAN/12

NOT FOR MANUFACTURING PURPOSES

0.018 kg VALUES IN PARENTHESIS ARE CALCULATED
AND MAY CONTAIN ROUNDOFF ERRORS
