amsikking/SOLS_O2-O3_optomechanics/thorlabs/SM2A33-AutoCADPDF.pdf

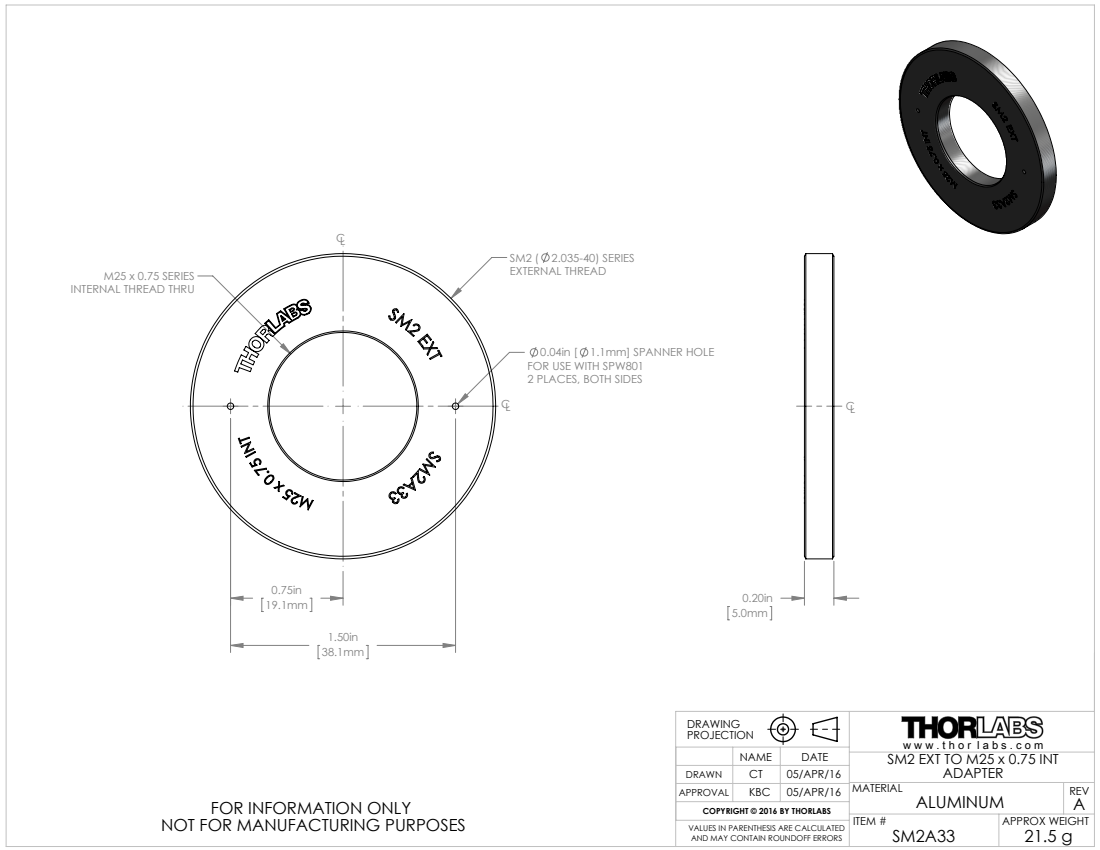
[picture p44: page 1]
SM2 ( 2.035-40) SERIES; ITEM #; APPROX WEIGHT; NAME; SM2 EXT TO M25 x 0.75 INT; FOR INFORMATION ONLY; COPYRIGHT © 2016 BY THORLABS

EXTERNAL THREAD M25 x 0.75 SERIES
INTERNAL THREAD THRU

0.04in [ 1.1mm] SPANNER HOLE
FOR USE WITH SPW801
2 PLACES, BOTH SIDES

DRAWN | CT | 05/APR/16
APPROVAL | KBC | 05/APR/16 | MATERIAL ALUMINUM | REV A

NOT FOR MANUFACTURING PURPOSES

21.5 g VALUES IN PARENTHESIS ARE CALCULATED
AND MAY CONTAIN ROUNDOFF ERRORS
